tlalexander/dancing-forest-pcb/Readme.md

PCB design files for The Dancing Forest, an interactive dynamic social art space

Please see https://www.thedancingforest.art/ for more info.
