tlalexander/dancing-forest-pcb/parts/df_bitmap.png

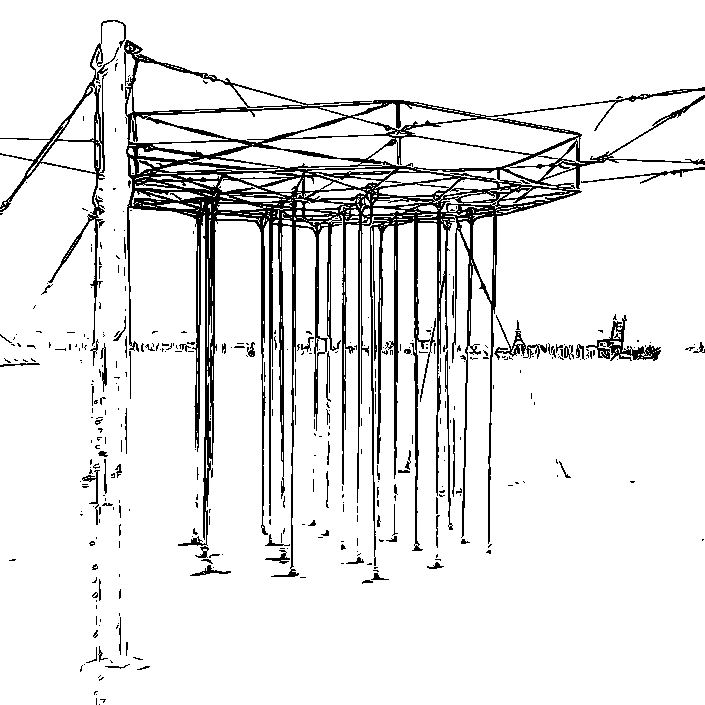
parts/df_bitmap.png
