tlalexander/dancing-forest-pcb/parts/ESP32-S3-MINI-1-N8--3DModel-STEP-1.STEP

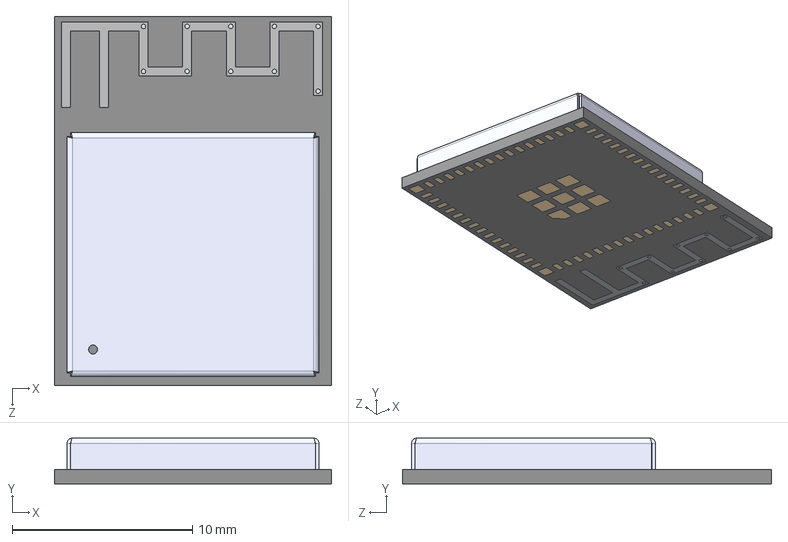
[picture p2: CAD file, 2023-08-24]
parts/ESP32-S3-MINI-1-N8--3DModel-STEP-1.STEP
15.4 x 2.55 x 20.5 mm
