tlalexander/dancing-forest-pcb/parts/2047110001--3DModel-STEP-56544.STEP

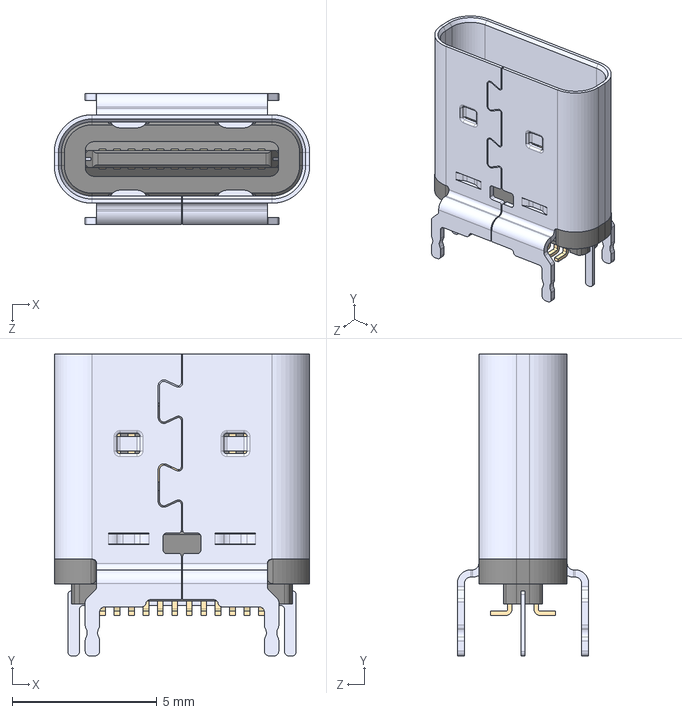
[picture p3: CAD file, 2023-07-04]
parts/2047110001--3DModel-STEP-56544.STEP
8.84 x 10.5 x 4.55 mm
