tlalexander/dancing-forest-pcb/(list of files, drawings)

Other design files:
freerouting.dsn
temp-freerouting.dsn
