tlalexander/dancing-forest-pcb/dancing_forest.kicad_pcb

## KiCad design dancing_forest.kicad_pcb (2023-08-24)

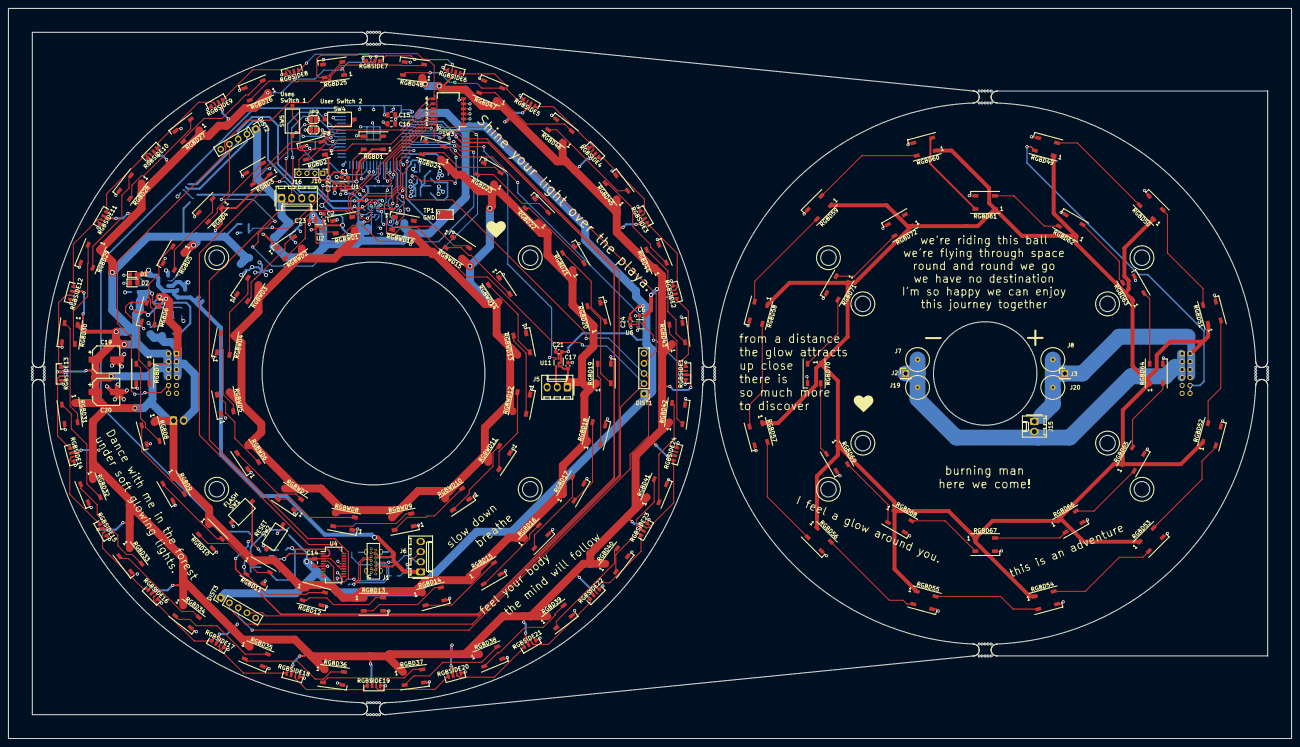
[picture p4: board dancing_forest.kicad_pcb from above]

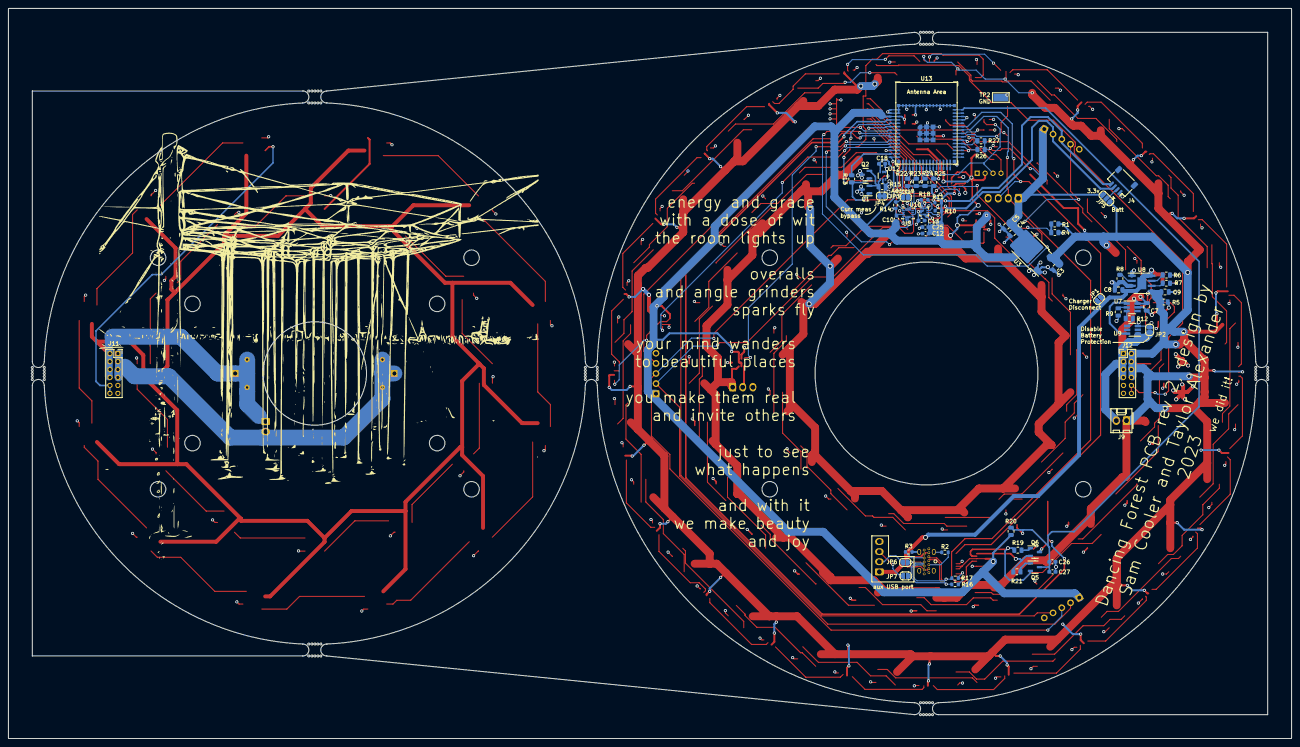
[picture p5: board dancing_forest.kicad_pcb from below]

Board: 4 copper layers, 322.5 x 183.5 mm, 238 parts (64 on the bottom side), 178 nets.

Parts:
C1, C2, C6, C10, C13, C17, C18, C21, C22, C23, C24, C25, C26: 0.1uF; C_0603_1608Metric
C3, C4, C5, C9, C16: 10u; C_0805_2012Metric
C7, C8, C14, C15: 0.1uF; C_0805_2012Metric
C12, C27: 1u; C_0603_1608Metric
C19, C20: 470uF 16V; CP_Elec_6.3x7.7
D1: RED; LED_0603_1608Metric
D2: GREEN; LED_0805_2012Metric
DIST1, DIST2, DIST3: Conn_01x05; 5_pin
H1, H2, H3, H4, H5, H6, H7, H8: MountingHole; MountingHole_3.2mm_Plastite_#4
H9: MountingHole_3.2mm_Plastite_#4; H9
H10: MountingHole_3.2mm_Plastite_#4; H10
H11: MountingHole_3.2mm_Plastite_#4; H11
H12: MountingHole_3.2mm_Plastite_#4; H12
J1: USB_C_Receptacle_USB2.0; 918-468K2029E50000
J2, J3: Conn_01x01; PinHeader_1x01_P2.54mm_Vertical
J4: SM04B-SRSS-TB(LF)(SN); JST_SH_SM04B-SRSS-TB_1x04-1MP_P1.00mm_Horizontal
J5: Conn_01x03; Molex_KK-254_AE-6410-03A_1x03_P2.54mm_Vertical
J6, J16: Conn_01x04; Molex_KK-254_AE-6410-04A_1x04_P2.54mm_Vertical
J7, J8, J19, J20: Conn_01x01; spring_F6-6-4-0.4Z
J9, J15: Conn_01x02; Molex_KK-254_AE-6410-02A_1x02_P2.54mm_Vertical
J10: Conn_01x04; PinHeader_1x04_P2.00mm_Vertical
J11: Upper Connector; PinSocket_2x06_P2.00mm_Vertical
J12: Lower Connector; PinHeader_2x06_P2.00mm_Vertical
JP1, JP2, JP3, JP4, JP6, JP7, JP8, JP9: SolderJumper_2_Open; SolderJumper-2_P1.3mm_Open_RoundedPad1.0x1.5mm
JP5: SolderJumper_3_Open; SolderJumper-3_P1.3mm_Open_RoundedPad1.0x1.5mm
Q1, Q2: AO3400A; SOT-23
Q5, Q6: Q_NPN_BEC; SOT-23-3
R1, R4, R19, R20, R21, R22, R23, R24, R25, R26, R27: 10k 0.5%; R_0805_2012Metric
R2, R3, R10, R11, R14, R18: 5.1k; R_0603_1608Metric
R5, R13: 100; R_0805_2012Metric
R6, R7, R9: 1k; R_0805_2012Metric
R8: 1.2k; R_0805_2012Metric
R12: 0R; R_0805_2012Metric
R15: 0.010 R; R_0805_2012Metric
R16, R17: 27; R_0603_1608Metric
RGBD1, RGBD2, RGBD3, RGBD4, RGBD5, RGBD6, RGBD7, RGBD8, RGBD9, RGBD10, RGBD11, RGBD12, RGBD13, RGBD14, RGBD15, RGBD16, RGBD17, RGBD18, RGBD19, RGBD20, RGBD21, RGBD22, RGBD23, RGBD24, RGBD25, RGBD26, RGBD27, RGBD28, RGBD29, RGBD30, RGBD31, RGBD32, RGBD33, RGBD34, RGBD35, RGBD36, RGBD37, RGBD38, RGBD39, RGBD40, RGBD41, RGBD42, RGBD43, RGBD44, RGBD45, RGBD46, RGBD47, RGBD48, RGBD49, RGBD50, RGBD51, RGBD52, RGBD53, RGBD54, RGBD55, RGBD56, RGBD57, RGBD58, RGBD59, RGBD60, RGBD61, RGBD62, RGBD63, RGBD64, RGBD65, RGBD66, RGBD67, RGBD68, RGBD69, RGBD70, RGBD71, RGBD72: WS2812B; LED_WS2812B_PLCC4_5.0x5.0mm_P3.2mm
RGBSIDE1, RGBSIDE2, RGBSIDE3, RGBSIDE4, RGBSIDE5, RGBSIDE6, RGBSIDE7, RGBSIDE8, RGBSIDE9, RGBSIDE10, RGBSIDE11, RGBSIDE12, RGBSIDE13, RGBSIDE14, RGBSIDE15, RGBSIDE16, RGBSIDE17, RGBSIDE18, RGBSIDE19, RGBSIDE20, RGBSIDE21, RGBSIDE22, RGBSIDE23, RGBSIDE24: SK6812-SIDE; SK6812SIDE
RGBWD1, RGBWD2, RGBWD3, RGBWD4, RGBWD5, RGBWD6, RGBWD7, RGBWD8, RGBWD9, RGBWD10, RGBWD11, RGBWD12, RGBWD13, RGBWD14, RGBWD15, RGBWD16: SK6812-RGBW; LED_SK6812_PLCC4_5.0x5.0mm_P3.2mm
SW1, SW2, SW4, SW5: SW_MEC_5G; SW_TS_1101_C_W
SW3: CONFIG SWITCH; SW_DIP_SPSTx06_Slide_KingTek_DSHP06TS_W7.62mm_P1.27mm
TP1, TP2: TestPoint; TestPoint_Keystone_5019_Minature
U1, U2, U6, U11: TXS0101DCKR; SOT-363_SC-70-6
U3: LD1086DT33TR; TO-252-2
U4: FT231XS; SSOP-20_3.9x8.7mm_P0.635mm
U5: LSM6DS3; LGA-14_3x2.5mm_P0.5mm_LayoutBorder3x4y
U7: DW01; SOT-23-6_Handsoldering
U8: TP4056; SOIC-8-1EP_3.9x4.9mm_P1.27mm_EP2.29x3mm
U9: FS8205A; SOT-23-6_Handsoldering
U10: LIS3MDL; LGA-12_2x2mm_P0.5mm
U12: INA199xxDCK; SOT-363_SC-70-6
U13: ESP32-S3-MINI-1-N8; ESP32-S3-MINI-1-breakout
mousebite1: VAL**; mousebite1
mousebite2: VAL**; mousebite2
mousebite3: VAL**; mousebite3
mousebite4: VAL**; mousebite4
mousebite5: VAL**; mousebite5
mousebite6: VAL**; mousebite6
mousebite7: VAL**; mousebite7

Connections:
+3V3: C4.1, C5.1, C10.1, C12.1, C14.1, C15.2, C16.2, C18.1, C21.1, C22.1, C23.1, C24.1, C25.1, DIST1.1, DIST2.1, DIST3.1, J16.1, JP3.1 (A), JP5.3 (B), R10.1, R11.2, R20.2, R22.1, R23.1, R24.1, R25.1, R26.1, R27.1, U1.1 (VCCA), U1.5 (OE), U2.1 (VCCA), U2.5 (OE), U3.2 (OUT), U4.3 (VCCIO), U4.14 (~RESET), U4.15 (VCC), U5.5 (VDDIO), U5.8 (VDD), U5.12 (CS), U6.1 (VCCA), U6.5 (OE), U10.5 (Vdd), U10.6 (Vdd_IO), U10.10 (~CS), U11.1 (VCCA), U11.5 (OE), U12.3 (V+), U13.3 (3V3)
+BATT: C1.1, C2.1, C3.1, C6.1, C9.1, C17.1, C19.1, C20.1, J3.1, J5.1, J8.1, J9.1, J10.2, J11.2, J11.4, J11.6, J11.8, J12.2, J12.4, J12.6, J12.8, J15.1, J20.1, JP5.1 (A), R1.1, R5.1, RGBD1.1 (VDD), RGBD2.1 (VDD), RGBD3.1 (VDD), RGBD4.1 (VDD), RGBD5.1 (VDD), RGBD6.1 (VDD), RGBD7.1 (VDD), RGBD8.1 (VDD), RGBD9.1 (VDD), RGBD10.1 (VDD), RGBD11.1 (VDD), RGBD12.1 (VDD), RGBD13.1 (VDD), RGBD14.1 (VDD), RGBD15.1 (VDD), RGBD16.1 (VDD), RGBD17.1 (VDD), RGBD18.1 (VDD), RGBD19.1 (VDD), RGBD20.1 (VDD), RGBD21.1 (VDD), RGBD22.1 (VDD), RGBD23.1 (VDD), RGBD24.1 (VDD), RGBD25.1 (VDD), RGBD26.1 (VDD), RGBD27.1 (VDD), RGBD28.1 (VDD), RGBD29.1 (VDD), RGBD30.1 (VDD), RGBD31.1 (VDD), RGBD32.1 (VDD), RGBD33.1 (VDD), RGBD34.1 (VDD), RGBD35.1 (VDD), RGBD36.1 (VDD), RGBD37.1 (VDD), RGBD38.1 (VDD), RGBD39.1 (VDD), RGBD40.1 (VDD), RGBD41.1 (VDD), RGBD42.1 (VDD), RGBD43.1 (VDD), RGBD44.1 (VDD), RGBD45.1 (VDD), RGBD46.1 (VDD), RGBD47.1 (VDD), RGBD48.1 (VDD), RGBD49.1 (VDD), RGBD50.1 (VDD), RGBD51.1 (VDD), RGBD52.1 (VDD), RGBD53.1 (VDD), RGBD54.1 (VDD), RGBD55.1 (VDD), RGBD56.1 (VDD), RGBD57.1 (VDD), RGBD58.1 (VDD), RGBD59.1 (VDD), RGBD60.1 (VDD), RGBD61.1 (VDD), RGBD62.1 (VDD), RGBD63.1 (VDD), RGBD64.1 (VDD), RGBD65.1 (VDD), RGBD66.1 (VDD), RGBD67.1 (VDD), RGBD68.1 (VDD), RGBD69.1 (VDD), RGBD70.1 (VDD), RGBD71.1 (VDD), RGBD72.1 (VDD), RGBSIDE1.2 (VDD), RGBSIDE2.2 (VDD), RGBSIDE3.2 (VDD), RGBSIDE4.2 (VDD), RGBSIDE5.2 (VDD), RGBSIDE6.2 (VDD), RGBSIDE7.2 (VDD), RGBSIDE8.2 (VDD), RGBSIDE9.2 (VDD), RGBSIDE10.2 (VDD), RGBSIDE11.2 (VDD), RGBSIDE12.2 (VDD), RGBSIDE13.2 (VDD), RGBSIDE14.2 (VDD), RGBSIDE15.2 (VDD), RGBSIDE16.2 (VDD), RGBSIDE17.2 (VDD), RGBSIDE18.2 (VDD), RGBSIDE19.2 (VDD), RGBSIDE20.2 (VDD), RGBSIDE21.2 (VDD), RGBSIDE22.2 (VDD), RGBSIDE23.2 (VDD), RGBSIDE24.2 (VDD), RGBWD1.3 (VDD), RGBWD2.3 (VDD), RGBWD3.3 (VDD), RGBWD4.3 (VDD), RGBWD5.3 (VDD), RGBWD6.3 (VDD), RGBWD7.3 (VDD), RGBWD8.3 (VDD), RGBWD9.3 (VDD), RGBWD10.3 (VDD), RGBWD11.3 (VDD), RGBWD12.3 (VDD), RGBWD13.3 (VDD), RGBWD14.3 (VDD), RGBWD15.3 (VDD), RGBWD16.3 (VDD), U1.6 (VCCB), U2.6 (VCCB), U3.3 (IN), U6.6 (VCCB), U8.5 (BAT), U11.6 (VCCB)
/G1: U7.1 (OD), U9.6 (G1)
/G2: R12.2, U9.4 (G2)
/OC: R12.1, U7.3 (OC)
/USB_DN: R17.2, U4.12 (USBDM)
/USB_DP: R16.2, U4.11 (USBDP)
ADDY_1: R22.2, SW3.12, U13.19 (GPIO15/U0RTS/ADC2_CH4/XTAL_32K_P)
ADDY_2: R23.2, SW3.11, U13.20 (GPIO16/U0CTS/ADC2_CH5/XTAL_32K_NH5)
ADDY_3: R24.2, SW3.10, U13.21 (GPIO17/U1TXD/ADC2_CH6)
ADDY_4: R25.2, SW3.9, U13.22 (GPIO18/U1RXD/ADC2_CH7/CLK_OUT3)
ADDY_5: R26.2, SW3.8, U13.34 (GPIO38/FSPIWP/SUBSPIWP)
ADDY_6: R27.2, SW3.7, U13.35 (MTCK/GPIO39/CLK_OUT3/SUBSPICS1)
AUX1: J10.3, JP9.2 (B), U13.25 (GPIO21)
AUX2: J10.4, JP8.2 (B), U13.38 (MTMS/GPIO42)
BAT-: C7.2, J2.1, J7.1, J9.2, J11.1, J11.3, J11.5, J11.7, J12.1, J12.3, J12.5, J12.7, J15.2, J19.1, JP2.1 (A), U7.6 (GND), U9.1 (S1)
BATT_MEASURE: R1.2, R4.1, U13.6 (GPIO2/TOUCH2/ADC1_CH1)
CURRENT_MEASURE: U12.6, U13.5 (GPIO1/TOUCH1/ADC1_CH0)
DN: J6.2, JP6.2 (B)
DP: J6.3, JP7.2 (B)
DRDY: U10.8 (DRDY), U13.23 (GPIO19/U1RTS/ADC2_CH8/CLK_OUT2/USB_D-)
EN: C26.1, C27.1, Q5.3 (C), R20.1, SW2.2, U13.45 (EN)
ESP_RX: J16.3, U4.20 (TXD), U13.40 (U0RXD/GPIO44/CLK_OUT2)
ESP_TX: J16.2, U4.4 (RXD), U13.39 (U0TXD/GPIO43/CLK_OUT1)
EXT_LED: U11.3 (A), U13.10 (GPIO6/TOUCH6/ADC1_CH5)
GND: C1.2, C2.2, C3.2, C4.2, C5.2, C6.2, C8.2, C9.2, C10.2, C12.2, C13.2, C14.2, C15.1, C16.1, C17.2, C18.2, C19.2, C20.2, C21.2, C22.2, C23.2, C24.2, C25.2, C26.2, C27.2, DIST1.5, DIST2.5, DIST3.5, J1.A1 (GND), J1.A12 (GND), J1.B1 (GND), J1.B12 (GND), J1.S1 (SHIELD), J4.1, J6.4, J10.1, J16.4, JP2.2 (B), JP4.1 (A), JP8.1 (A), JP9.1 (A), R2.1, R3.2, R4.2, R8.2, R9.1, R14.1, R15.2, R18.1, SW1.1, SW2.1, SW3.1, SW3.2, SW3.3, SW3.4, SW3.5, SW3.6, SW4.1, SW5.1, TP1.1, TP2.1, U1.2 (GND), U2.2 (GND), U3.1 (ADJ/GND), U4.6 (GND), U4.16 (GND), U5.2 (SDX), U5.3 (SCX), U5.6 (GND), U5.7 (GND), U6.2 (GND), U8.1 (TEMP), U8.3 (GND), U9.3 (S2), U10.2 (GND), U10.3 (GND), U10.12 (GND), U11.2 (GND), U12.1 (REF), U12.2 (GND), U12.5 (-), U13.1 (GND), U13.2 (GND), U13.42 (GND), U13.43 (GND), U13.46 (GND), U13.47 (GND), U13.48 (GND), U13.49 (GND), U13.50 (GND), U13.51 (GND), U13.52 (GND), U13.53 (GND), U13.54 (GND), U13.55 (GND), U13.56 (GND), U13.57 (GND), U13.58 (GND), U13.59 (GND), U13.60 (GND), U13.61 (GND), U13.62 (GND), U13.63 (GND), U13.64 (GND), U13.65 (GND)
INT: U10.7 (INT), U13.24 (GPIO20/U1CTS/ADC2_CH9/CLK_OUT1/USB_D+)
INT1: U5.4 (INT1), U13.17 (GPIO13/TOUCH13/ADC2_CH2/FSPIQ/FSPIIO7/S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)
INT2: U5.9 (INT2), U13.18 (GPIO14/TOUCH14/ADC2_CH3/FSPIWP/FSPIDQS/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)
IO0: Q6.3 (C), SW1.2, U13.4 (GPIO0/BOOT)
LEDGND: J5.3, J11.9, J11.11, J12.9, J12.11, Q1.3 (D), Q2.3 (D), RGBD1.3 (VSS), RGBD2.3 (VSS), RGBD3.3 (VSS), RGBD4.3 (VSS), RGBD5.3 (VSS), RGBD6.3 (VSS), RGBD7.3 (VSS), RGBD8.3 (VSS), RGBD9.3 (VSS), RGBD10.3 (VSS), RGBD11.3 (VSS), RGBD12.3 (VSS), RGBD13.3 (VSS), RGBD14.3 (VSS), RGBD15.3 (VSS), RGBD16.3 (VSS), RGBD17.3 (VSS), RGBD18.3 (VSS), RGBD19.3 (VSS), RGBD20.3 (VSS), RGBD21.3 (VSS), RGBD22.3 (VSS), RGBD23.3 (VSS), RGBD24.3 (VSS), RGBD25.3 (VSS), RGBD26.3 (VSS), RGBD27.3 (VSS), RGBD28.3 (VSS), RGBD29.3 (VSS), RGBD30.3 (VSS), RGBD31.3 (VSS), RGBD32.3 (VSS), RGBD33.3 (VSS), RGBD34.3 (VSS), RGBD35.3 (VSS), RGBD36.3 (VSS), RGBD37.3 (VSS), RGBD38.3 (VSS), RGBD39.3 (VSS), RGBD40.3 (VSS), RGBD41.3 (VSS), RGBD42.3 (VSS), RGBD43.3 (VSS), RGBD44.3 (VSS), RGBD45.3 (VSS), RGBD46.3 (VSS), RGBD47.3 (VSS), RGBD48.3 (VSS), RGBD49.3 (VSS), RGBD50.3 (VSS), RGBD51.3 (VSS), RGBD52.3 (VSS), RGBD53.3 (VSS), RGBD54.3 (VSS), RGBD55.3 (VSS), RGBD56.3 (VSS), RGBD57.3 (VSS), RGBD58.3 (VSS), RGBD59.3 (VSS), RGBD60.3 (VSS), RGBD61.3 (VSS), RGBD62.3 (VSS), RGBD63.3 (VSS), RGBD64.3 (VSS), RGBD65.3 (VSS), RGBD66.3 (VSS), RGBD67.3 (VSS), RGBD68.3 (VSS), RGBD69.3 (VSS), RGBD70.3 (VSS), RGBD71.3 (VSS), RGBD72.3 (VSS), RGBSIDE1.4 (VSS), RGBSIDE2.4 (VSS), RGBSIDE3.4 (VSS), RGBSIDE4.4 (VSS), RGBSIDE5.4 (VSS), RGBSIDE6.4 (VSS), RGBSIDE7.4 (VSS), RGBSIDE8.4 (VSS), RGBSIDE9.4 (VSS), RGBSIDE10.4 (VSS), RGBSIDE11.4 (VSS), RGBSIDE12.4 (VSS), RGBSIDE13.4 (VSS), RGBSIDE14.4 (VSS), RGBSIDE15.4 (VSS), RGBSIDE16.4 (VSS), RGBSIDE17.4 (VSS), RGBSIDE18.4 (VSS), RGBSIDE19.4 (VSS), RGBSIDE20.4 (VSS), RGBSIDE21.4 (VSS), RGBSIDE22.4 (VSS), RGBSIDE23.4 (VSS), RGBSIDE24.4 (VSS), RGBWD1.1 (VSS), RGBWD2.1 (VSS), RGBWD3.1 (VSS), RGBWD4.1 (VSS), RGBWD5.1 (VSS), RGBWD6.1 (VSS), RGBWD7.1 (VSS), RGBWD8.1 (VSS), RGBWD9.1 (VSS), RGBWD10.1 (VSS), RGBWD11.1 (VSS), RGBWD12.1 (VSS), RGBWD13.1 (VSS), RGBWD14.1 (VSS), RGBWD15.1 (VSS), RGBWD16.1 (VSS)
LED_FET: R13.2, U13.14 (GPIO10/TOUCH10/ADC1_CH9/FSPICS0/FSPIIO4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)
unnamed: D1.1 (K), R6.1
unnamed: D2.1 (K), R7.1
unnamed: J1.A5 (CC1), R2.2
unnamed: J1.B5 (CC2), R3.1
unnamed: J4.2, JP5.2 (C)
unnamed: J5.2, U11.4 (B)
unnamed: JP3.2 (B), R14.2, U5.1 (SDO/SA0)
unnamed: JP4.2 (B), Q1.2 (S), Q2.2 (S), R15.1, U12.4 (+)
unnamed: Q1.1 (G), Q2.1 (G), R13.1
unnamed: Q5.1 (B), R21.2
unnamed: Q6.1 (B), R19.1
unnamed: RGBD1.4 (DIN), U1.4 (B)
unnamed: RGBD1.2 (DOUT), RGBD2.4 (DIN)
unnamed: RGBD2.2 (DOUT), RGBD3.4 (DIN)
unnamed: RGBD3.2 (DOUT), RGBD4.4 (DIN)
unnamed: RGBD4.2 (DOUT), RGBD5.4 (DIN)
unnamed: RGBD5.2 (DOUT), RGBD6.4 (DIN)
unnamed: RGBD6.2 (DOUT), RGBD7.4 (DIN)
unnamed: RGBD7.2 (DOUT), RGBD8.4 (DIN)
unnamed: RGBD8.2 (DOUT), RGBD9.4 (DIN)
unnamed: RGBD9.2 (DOUT), RGBD10.4 (DIN)
unnamed: RGBD10.2 (DOUT), RGBD11.4 (DIN)
unnamed: RGBD11.2 (DOUT), RGBD12.4 (DIN)
unnamed: RGBD12.2 (DOUT), RGBD13.4 (DIN)
unnamed: RGBD13.2 (DOUT), RGBD14.4 (DIN)
unnamed: RGBD14.2 (DOUT), RGBD15.4 (DIN)
unnamed: RGBD15.2 (DOUT), RGBD16.4 (DIN)
unnamed: RGBD16.2 (DOUT), RGBD17.4 (DIN)
unnamed: RGBD17.2 (DOUT), RGBD18.4 (DIN)
unnamed: RGBD18.2 (DOUT), RGBD19.4 (DIN)
unnamed: RGBD19.2 (DOUT), RGBD20.4 (DIN)
unnamed: RGBD20.2 (DOUT), RGBD21.4 (DIN)
unnamed: RGBD21.2 (DOUT), RGBD22.4 (DIN)
unnamed: RGBD22.2 (DOUT), RGBD23.4 (DIN)
unnamed: RGBD23.2 (DOUT), RGBD24.4 (DIN)
unnamed: RGBD24.2 (DOUT), RGBD25.4 (DIN)
unnamed: RGBD25.2 (DOUT), RGBD26.4 (DIN)
unnamed: RGBD26.2 (DOUT), RGBD27.4 (DIN)
unnamed: RGBD27.2 (DOUT), RGBD28.4 (DIN)
unnamed: RGBD28.2 (DOUT), RGBD29.4 (DIN)
unnamed: RGBD29.2 (DOUT), RGBD30.4 (DIN)
unnamed: RGBD30.2 (DOUT), RGBD31.4 (DIN)
unnamed: RGBD31.2 (DOUT), RGBD32.4 (DIN)
unnamed: RGBD32.2 (DOUT), RGBD33.4 (DIN)
unnamed: RGBD33.2 (DOUT), RGBD34.4 (DIN)
unnamed: RGBD34.2 (DOUT), RGBD35.4 (DIN)
unnamed: RGBD35.2 (DOUT), RGBD36.4 (DIN)
unnamed: RGBD36.2 (DOUT), RGBD37.4 (DIN)
unnamed: RGBD37.2 (DOUT), RGBD38.4 (DIN)
unnamed: RGBD38.2 (DOUT), RGBD39.4 (DIN)
unnamed: RGBD39.2 (DOUT), RGBD40.4 (DIN)
unnamed: RGBD40.2 (DOUT), RGBD41.4 (DIN)
unnamed: RGBD41.2 (DOUT), RGBD42.4 (DIN)
unnamed: RGBD42.2 (DOUT), RGBD43.4 (DIN)
unnamed: RGBD43.2 (DOUT), RGBD44.4 (DIN)
unnamed: RGBD44.2 (DOUT), RGBD45.4 (DIN)
unnamed: RGBD45.2 (DOUT), RGBD46.4 (DIN)
unnamed: RGBD46.2 (DOUT), RGBD47.4 (DIN)
unnamed: RGBD47.2 (DOUT), RGBD48.4 (DIN)
unnamed: RGBD49.2 (DOUT), RGBD50.4 (DIN)
unnamed: RGBD50.2 (DOUT), RGBD51.4 (DIN)
unnamed: RGBD51.2 (DOUT), RGBD52.4 (DIN)
unnamed: RGBD52.2 (DOUT), RGBD53.4 (DIN)
unnamed: RGBD53.2 (DOUT), RGBD54.4 (DIN)
unnamed: RGBD54.2 (DOUT), RGBD55.4 (DIN)
unnamed: RGBD55.2 (DOUT), RGBD56.4 (DIN)
unnamed: RGBD56.2 (DOUT), RGBD57.4 (DIN)
unnamed: RGBD57.2 (DOUT), RGBD58.4 (DIN)
unnamed: RGBD58.2 (DOUT), RGBD59.4 (DIN)
unnamed: RGBD59.2 (DOUT), RGBD60.4 (DIN)
unnamed: RGBD60.2 (DOUT), RGBD61.4 (DIN)
unnamed: RGBD61.2 (DOUT), RGBD62.4 (DIN)
unnamed: RGBD62.2 (DOUT), RGBD63.4 (DIN)
unnamed: RGBD63.2 (DOUT), RGBD64.4 (DIN)
unnamed: RGBD64.2 (DOUT), RGBD65.4 (DIN)
unnamed: RGBD65.2 (DOUT), RGBD66.4 (DIN)
unnamed: RGBD66.2 (DOUT), RGBD67.4 (DIN)
unnamed: RGBD67.2 (DOUT), RGBD68.4 (DIN)
unnamed: RGBD68.2 (DOUT), RGBD69.4 (DIN)
unnamed: RGBD69.2 (DOUT), RGBD70.4 (DIN)
unnamed: RGBD70.2 (DOUT), RGBD71.4 (DIN)
unnamed: RGBD71.2 (DOUT), RGBD72.4 (DIN)
unnamed: RGBSIDE1.1 (DIN), U6.4 (B)
unnamed: RGBSIDE1.3 (DOUT), RGBSIDE2.1 (DIN)
unnamed: RGBSIDE2.3 (DOUT), RGBSIDE3.1 (DIN)
unnamed: RGBSIDE3.3 (DOUT), RGBSIDE4.1 (DIN)
unnamed: RGBSIDE4.3 (DOUT), RGBSIDE5.1 (DIN)
unnamed: RGBSIDE5.3 (DOUT), RGBSIDE6.1 (DIN)
unnamed: RGBSIDE6.3 (DOUT), RGBSIDE7.1 (DIN)
unnamed: RGBSIDE7.3 (DOUT), RGBSIDE8.1 (DIN)
unnamed: RGBSIDE8.3 (DOUT), RGBSIDE9.1 (DIN)
unnamed: RGBSIDE9.3 (DOUT), RGBSIDE10.1 (DIN)
unnamed: RGBSIDE10.3 (DOUT), RGBSIDE11.1 (DIN)
unnamed: RGBSIDE11.3 (DOUT), RGBSIDE12.1 (DIN)
unnamed: RGBSIDE12.3 (DOUT), RGBSIDE13.1 (DIN)
unnamed: RGBSIDE13.3 (DOUT), RGBSIDE14.1 (DIN)
unnamed: RGBSIDE14.3 (DOUT), RGBSIDE15.1 (DIN)
unnamed: RGBSIDE15.3 (DOUT), RGBSIDE16.1 (DIN)
unnamed: RGBSIDE16.3 (DOUT), RGBSIDE17.1 (DIN)
unnamed: RGBSIDE17.3 (DOUT), RGBSIDE18.1 (DIN)
unnamed: RGBSIDE18.3 (DOUT), RGBSIDE19.1 (DIN)
unnamed: RGBSIDE19.3 (DOUT), RGBSIDE20.1 (DIN)
unnamed: RGBSIDE20.3 (DOUT), RGBSIDE21.1 (DIN)
unnamed: RGBSIDE21.3 (DOUT), RGBSIDE22.1 (DIN)
unnamed: RGBSIDE22.3 (DOUT), RGBSIDE23.1 (DIN)
unnamed: RGBSIDE23.3 (DOUT), RGBSIDE24.1 (DIN)
unnamed: RGBWD1.2 (DIN), U2.4 (B)
unnamed: RGBWD1.4 (DOUT), RGBWD2.2 (DIN)
unnamed: RGBWD2.4 (DOUT), RGBWD3.2 (DIN)
unnamed: RGBWD3.4 (DOUT), RGBWD4.2 (DIN)
unnamed: RGBWD4.4 (DOUT), RGBWD5.2 (DIN)
unnamed: RGBWD5.4 (DOUT), RGBWD6.2 (DIN)
unnamed: RGBWD6.4 (DOUT), RGBWD7.2 (DIN)
unnamed: RGBWD7.4 (DOUT), RGBWD8.2 (DIN)
unnamed: RGBWD8.4 (DOUT), RGBWD9.2 (DIN)
unnamed: RGBWD9.4 (DOUT), RGBWD10.2 (DIN)
unnamed: RGBWD10.4 (DOUT), RGBWD11.2 (DIN)
unnamed: RGBWD11.4 (DOUT), RGBWD12.2 (DIN)
unnamed: RGBWD12.4 (DOUT), RGBWD13.2 (DIN)
unnamed: RGBWD13.4 (DOUT), RGBWD14.2 (DIN)
unnamed: RGBWD14.4 (DOUT), RGBWD15.2 (DIN)
unnamed: RGBWD15.4 (DOUT), RGBWD16.2 (DIN)
unnamed: R9.2, U7.2 (CS)
unnamed: C7.1, R5.2, U7.5 (VCC)
unnamed: R8.1, U8.2 (PROG)
unnamed: R6.2, U8.7 (~CHRG)
unnamed: R7.2, U8.6 (~STDBY)
unnamed: C13.1, U10.4 (C1)
unnamed: R18.2, U10.9 (SDO/SA1)
unnamed: SW5.2, U13.37 (MTDI/GPIO41/CLK_OUT1)
unnamed: SW4.2, U13.36 (MTDO/GPIO40/CLK_OUT2)
RGB-LOWER-OUT: J12.10, J12.12, RGBD48.2 (DOUT)
RGB-UPPER-IN: J11.10, J11.12, RGBD49.4 (DIN)
SCL: DIST1.3, DIST2.3, DIST3.3, J4.4, R11.1, U5.13 (SCL), U10.1 (SCL/SPC), U13.15 (GPIO11/TOUCH11/ADC2_CH0/FSPID/FSPIIO5/S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)
SDA: DIST1.2, DIST2.2, DIST3.2, J4.3, R10.2, U5.14 (SDA), U10.11 (SDA/SDI/SDO), U13.16 (GPIO12/TOUCH12/ADC2_CH1/FSPICLK/FSPIIO6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)
SK6812-RGBW: U2.3 (A), U13.11 (GPIO7/TOUCH7/ADC1_CH6)
SK6812-SIDE: U6.3 (A), U13.12 (GPIO8/TOUCH8/ADC1_CH7/SUBSPICS1)
USB_D+: J1.A6 (D+), J1.B6 (D+), JP7.1 (A), R16.1
USB_D-: J1.A7 (D-), J1.B7 (D-), JP6.1 (A), R17.1
VBUS: C8.1, D1.2 (A), D2.2 (A), J1.A4 (VBUS), J1.A9 (VBUS), J1.B4 (VBUS), J1.B9 (VBUS), J6.1, JP1.1 (A), JP1.2 (B), U8.4 (VCC), U8.8 (CE), U8.9 (PP)
WS2812: U1.3 (A), U13.13 (GPIO9/TOUCH9/ADC1_CH8/FSPIHD/SUBSPIHD)
XSHUT1: DIST1.4, U13.7 (GPIO3/TOUCH3/ADC1_CH2)
XSHUT2: DIST2.4, U13.8 (GPIO4/TOUCH4/ADC1_CH3)
XSHUT3: DIST3.4, U13.9 (GPIO5/TOUCH5/ADC1_CH4)
~DTR: Q6.2 (E), R21.1, U4.1 (~DTR)
~RTS: Q5.2 (E), R19.2, U4.2 (~RTS)
