tlalexander/dancing-forest-pcb/(commit log)

2023-07-04 initial commit - first version of the dancing forest!
    [2047110001--3DModel-STEP-56544.STEP, Part Studio 1 - Sketch 1.dxf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]
2023-08-24 Updated files including PCB fix. Added license.
    [ESP32-S3-MINI-1-N8--3DModel-STEP-1.STEP, dancing_forest.kicad_pcb, dancing_forest.kicad_sch, dancing_forest_version_1.kicad_pcb]
2023-08-24 remove some unnecessary files
    [Part Studio 1 - Sketch 1.dxf, project2.kicad_pcb, untitled.kicad_pcb]
